EllianCarlos/SegurancaAutomotiva/(commit log)

2019-06-16 No ramo master Your branch is up to date with 'origin/master'.
    Mudanças a serem submetidas:
    deleted: Final_parte8.ino
    deleted: esp32comArduinoBuffer.ino
    Arquivos não monitorados:
    ArduinoScripts/
2019-06-16 Mudanças a serem submetidas: new file: ArduinoScripts/Final_parte8/Final_parte8.ino new file: ArduinoScripts/esp32comArduinoBuffer/esp32comArduinoBuffer.ino
2019-07-23 Mudanças a serem submetidas: deleted: ArduinoScripts/Final_parte8/Final_parte8.ino deleted: ArduinoScripts/MonitoramentoSeguranca_Central.ino deleted: ArduinoScripts/esp32comArduinoBuffer/esp32comArd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
2019-07-23 Mudanças a serem submetidas: deleted: ServidorFiles/canToInt.ino
    ArduinoScripts/Final/
    ArduinoScripts/MonitoramentoSeguranca_Central/
    ArduinoScripts/esp32toArduinoBuffer/
    Artigo/
    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
2019-07-23 Mudanças a serem submetidas: new file: ArduinoScripts/.vscode/c_cpp_properties.json new file: ArduinoScripts/Final/Final.ino new file: ArduinoScripts/MonitoramentoSeguranca_Central/MonitoramentoSegur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
